katolabmain/shortcut_keyboard/PCB(kicad)/RP2040_key_board.step

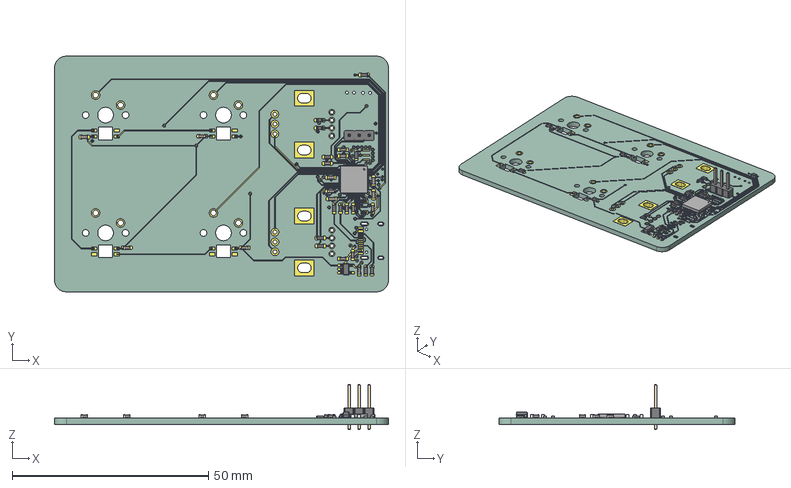
[picture p1: CAD file, 2026-10-30]
PCB(kicad)/RP2040_key_board.step
85.0 x 60.0 x 11.5 mm
R_0603_1608Metric x 11
C_0603_1608Metric x 18
QFN_56_1EP_7x7mm_P04mm_EP32x32mm
PinHeader_1x03_P254mm_Vertical
SOT_23_5
RP2040_key_board_track_1
RP2040_key_board_track_2
RP2040_key_board_track_3
RP2040_key_board_track_4
RP2040_key_board_track_5
RP2040_key_board_track_6
RP2040_key_board_track_7
RP2040_key_board_track_8
RP2040_key_board_track_9
RP2040_key_board_track_10
RP2040_key_board_track_11
RP2040_key_board_track_12
RP2040_key_board_track_13
RP2040_key_board_track_14
RP2040_key_board_track_15
RP2040_key_board_track_16
RP2040_key_board_track_17
RP2040_key_board_track_18
RP2040_key_board_track_19
RP2040_key_board_track_20
RP2040_key_board_track_21
RP2040_key_board_track_22
RP2040_key_board_track_23
RP2040_key_board_track_24
RP2040_key_board_track_25
RP2040_key_board_track_26
RP2040_key_board_track_27
RP2040_key_board_track_28
RP2040_key_board_track_29
RP2040_key_board_track_30
RP2040_key_board_track_31
RP2040_key_board_track_32
RP2040_key_board_track_33
RP2040_key_board_track_34
RP2040_key_board_track_35
RP2040_key_board_track_36
RP2040_key_board_track_37
RP2040_key_board_track_38
RP2040_key_board_track_39
RP2040_key_board_track_40
RP2040_key_board_track_41
RP2040_key_board_track_42
RP2040_key_board_track_43
RP2040_key_board_track_44
RP2040_key_board_track_45
RP2040_key_board_track_46
RP2040_key_board_track_47
RP2040_key_board_track_48
RP2040_key_board_track_49
RP2040_key_board_track_50
RP2040_key_board_track_51
RP2040_key_board_track_52
RP2040_key_board_track_53
RP2040_key_board_track_54
RP2040_key_board_track_55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
