katolabmain/shortcut_keyboard/PCB(kicad)/RP2040_key_board.kicad_pcb

## KiCad design PCB(kicad)/RP2040_key_board.kicad_pcb (2026-10-30)

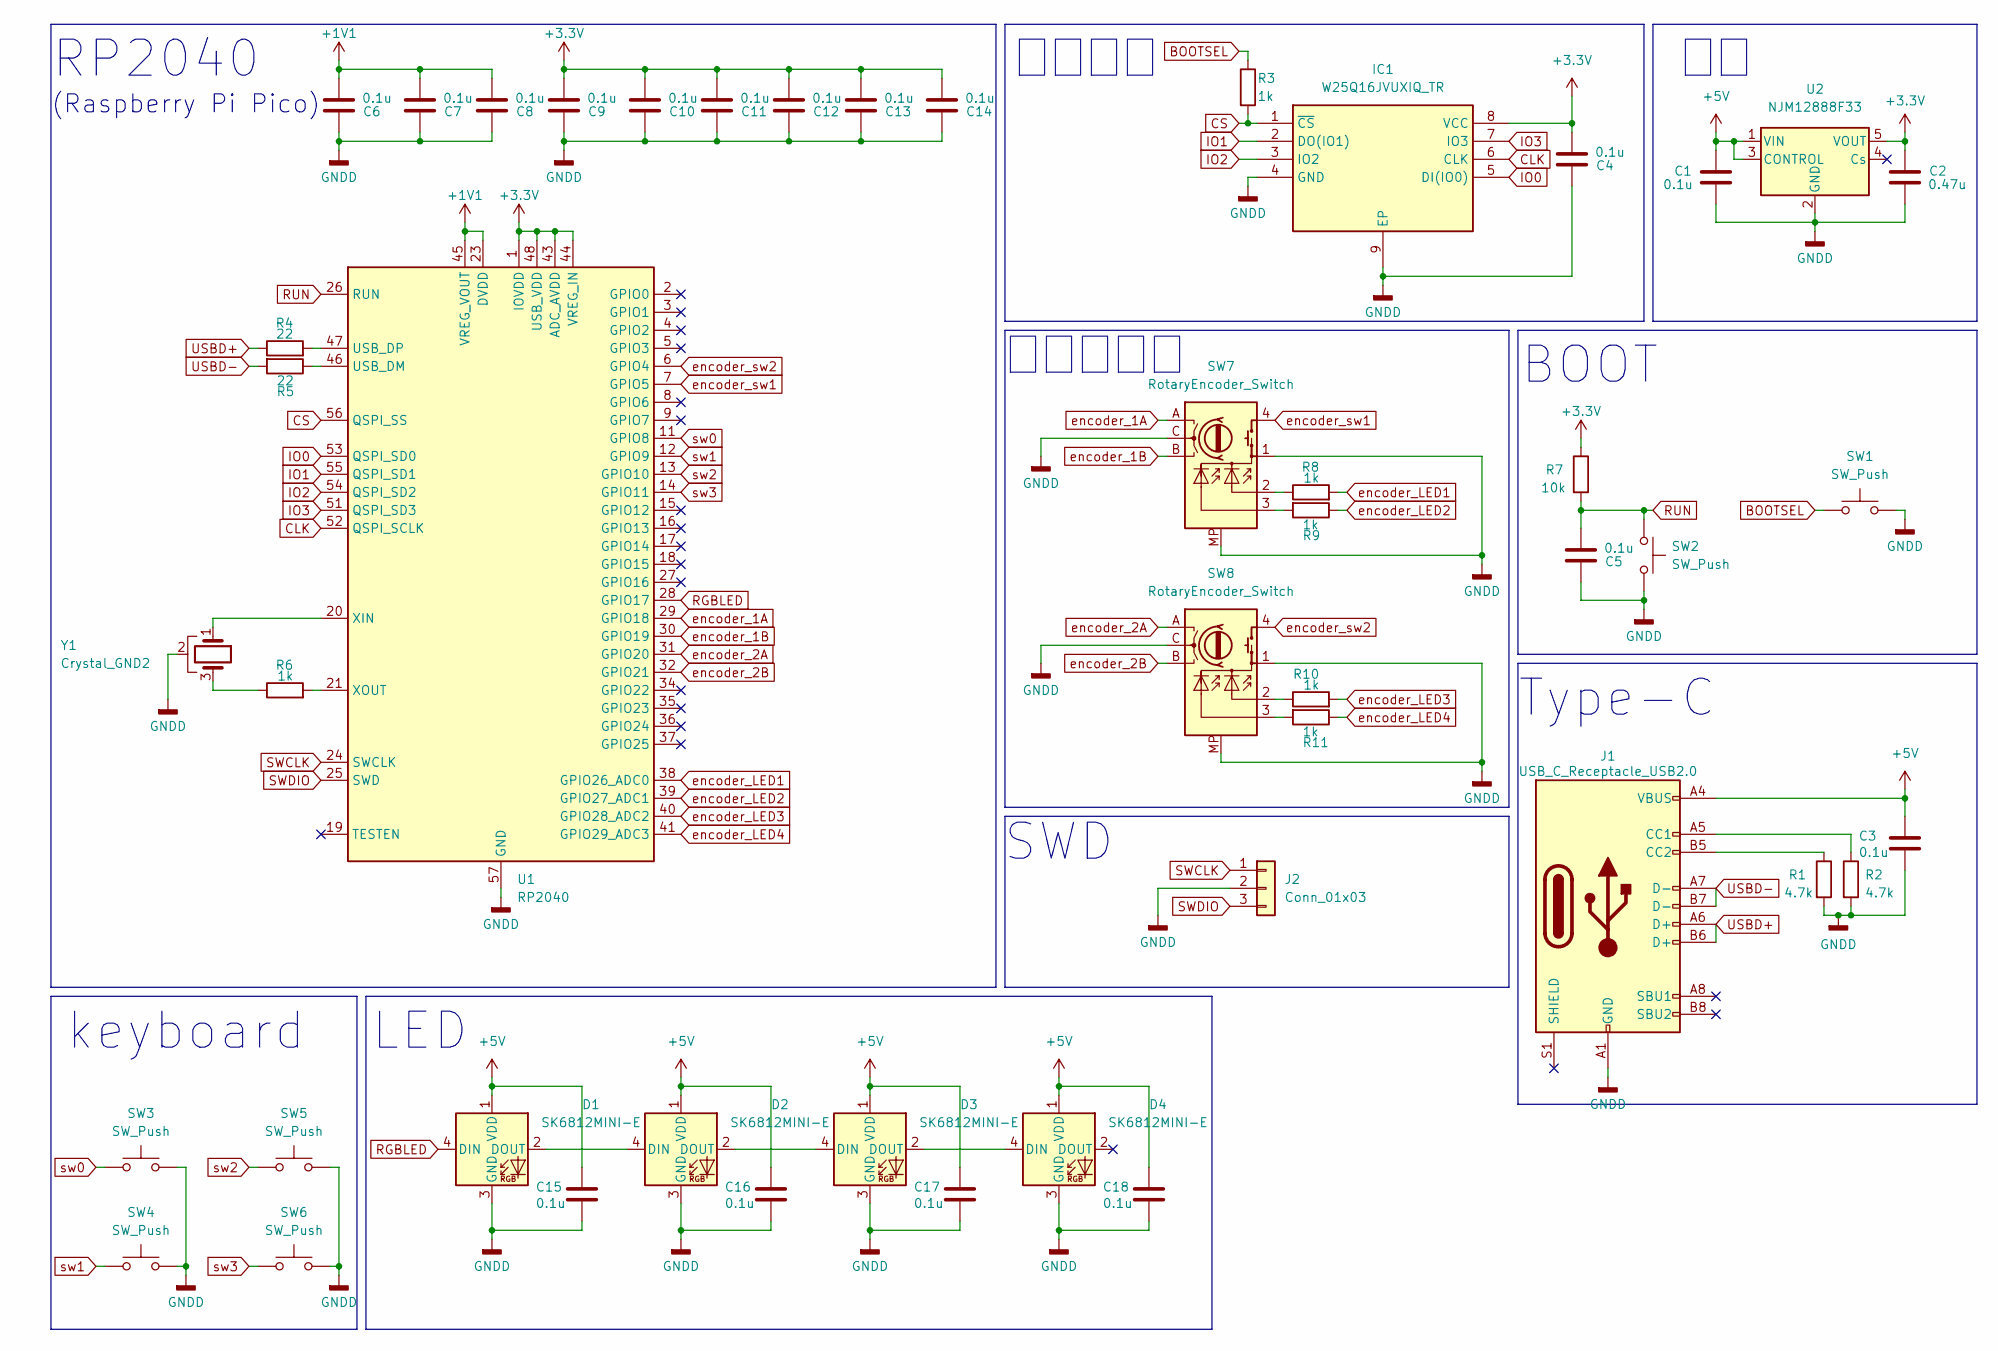
[picture p3: schematic RP2040_key_board.kicad_sch]

Parts:
C1, C3, C4, C5, C6, C7, C8, C9, C10, C11, C12, C13, C14, C15, C16, C17, C18: 0.1u; C_0603_1608Metric_Pad1.08x0.95mm_HandSolder
C2: 0.47u; C_0603_1608Metric_Pad1.08x0.95mm_HandSolder
D1, D2, D3, D4: SK6812MINI-E
IC1: W25Q16JVUXIQ_TR; SON50P300X200X60-9N; Mouser Part Number 454-W25Q16JVUXIQTR
J1: USB_C_Receptacle_USB2.0; USB_C_Receptacle_HRO_TYPE-C-31-M-12
J2: Conn_01x03; PinHeader_1x03_P2.54mm_Vertical
R1, R2: 4.7k; R_0603_1608Metric_Pad0.98x0.95mm_HandSolder
R3, R6, R8, R9, R10, R11: 1k; R_0603_1608Metric_Pad0.98x0.95mm_HandSolder
R4, R5: 22; R_0603_1608Metric_Pad0.98x0.95mm_HandSolder
R7: 10k; R_0603_1608Metric_Pad0.98x0.95mm_HandSolder
SW1, SW2: SW_Push; switch_TVAF06-A020B-R
SW3, SW4, SW5, SW6: SW_Push; SW_Cherry_MX_1.00u_PCB
SW7, SW8: RotaryEncoder_Switch; EC12PLGRSDVF-D-25K-24-24C-310
U1: RP2040; QFN-56-1EP_7x7mm_P0.4mm_EP3.2x3.2mm
U2: NJM12888F33; SOT-23-5_HandSoldering
Y1: Crystal_GND2; CSTNE16M0V530000R0

Connections:
+1V1: C6.2, C7.2, C8.2, U1.23 (DVDD), U1.45 (VREG_VOUT), U1.50 (DVDD)
+3.3V: C2.1, C4.2, C9.2, C10.2, C11.2, C12.2, C13.2, C14.2, IC1.8 (VCC), R7.1, U1.1 (IOVDD), U1.10 (IOVDD), U1.22 (IOVDD), U1.33 (IOVDD), U1.42 (IOVDD), U1.43 (ADC_AVDD), U1.44 (VREG_IN), U1.48 (USB_VDD), U1.49 (IOVDD), U2.5 (VOUT)
+5V: C1.1, C3.1, C15.1, C16.1, C17.1, C18.1, D1.1 (VDD), D2.1 (VDD), D3.1 (VDD), D4.1 (VDD), J1.A4 (VBUS), J1.A9 (VBUS), J1.B4 (VBUS), J1.B9 (VBUS), U2.1 (VIN), U2.3 (CONTROL)
BOOTSEL: R3.1, SW1.1
CLK: IC1.6 (CLK), U1.52 (QSPI_SCLK)
CS: IC1.1 (~CS), R3.2, U1.56 (QSPI_SS)
GNDD: C1.2, C2.2, C3.2, C4.1, C5.1, C6.1, C7.1, C8.1, C9.1, C10.1, C11.1, C12.1, C13.1, C14.1, C15.2, C16.2, C17.2, C18.2, D1.3 (GND), D2.3 (GND), D3.3 (GND), D4.3 (GND), IC1.4 (GND), IC1.9 (EP), J1.A1 (GND), J1.A12 (GND), J1.B1 (GND), J1.B12 (GND), J2.2, R1.2, R2.2, SW1.2, SW2.2, SW3.2, SW4.2, SW5.2, SW6.2, SW7.1, SW7.C, SW7.MP, SW8.1, SW8.C, SW8.MP, U1.57 (GND), U2.2 (GND), Y1.2
IO0: IC1.5 (DI(IO0)), U1.53 (QSPI_SD0)
IO1: IC1.2 (DO(IO1)), U1.55 (QSPI_SD1)
IO2: IC1.3 (IO2), U1.54 (QSPI_SD2)
IO3: IC1.7 (IO3), U1.51 (QSPI_SD3)
unnamed: D1.2 (DOUT), D2.4 (DIN)
unnamed: D2.2 (DOUT), D3.4 (DIN)
unnamed: D3.2 (DOUT), D4.4 (DIN)
unnamed: J1.A5 (CC1), R2.1
unnamed: J1.B5 (CC2), R1.1
unnamed: R6.1, Y1.3
unnamed: R8.1, SW7.2
unnamed: R9.2, SW7.3
unnamed: R10.1, SW8.2
unnamed: R11.2, SW8.3
unnamed: R5.1, U1.46 (USB_DM)
unnamed: R4.2, U1.47 (USB_DP)
unnamed: U1.20 (XIN), Y1.1
unnamed: R6.2, U1.21 (XOUT)
RGBLED: D1.4 (DIN), U1.28 (GPIO17)
RUN: C5.2, R7.2, SW2.1, U1.26 (RUN)
SWCLK: J2.1, U1.24 (SWCLK)
SWDIO: J2.3, U1.25 (SWD)
USBD+: J1.A6 (D+), J1.B6 (D+), R4.1
USBD-: J1.A7 (D-), J1.B7 (D-), R5.2
encoder_1A: SW7.A, U1.29 (GPIO18)
encoder_1B: SW7.B, U1.30 (GPIO19)
encoder_2A: SW8.A, U1.31 (GPIO20)
encoder_2B: SW8.B, U1.32 (GPIO21)
encoder_LED1: R8.2, U1.38 (GPIO26_ADC0)
encoder_LED2: R9.1, U1.39 (GPIO27_ADC1)
encoder_LED3: R10.2, U1.40 (GPIO28_ADC2)
encoder_LED4: R11.1, U1.41 (GPIO29_ADC3)
encoder_sw1: SW7.4, U1.7 (GPIO5)
encoder_sw2: SW8.4, U1.6 (GPIO4)
sw0: SW3.1, U1.11 (GPIO8)
sw1: SW4.1, U1.12 (GPIO9)
sw2: SW5.1, U1.13 (GPIO10)
sw3: SW6.1, U1.14 (GPIO11)

Notes on the sheet:
LED
BOOT
Type-C
RP2040
エンコーダ
keyboard
メモリー
SWD
(Raspberry Pi Pico)

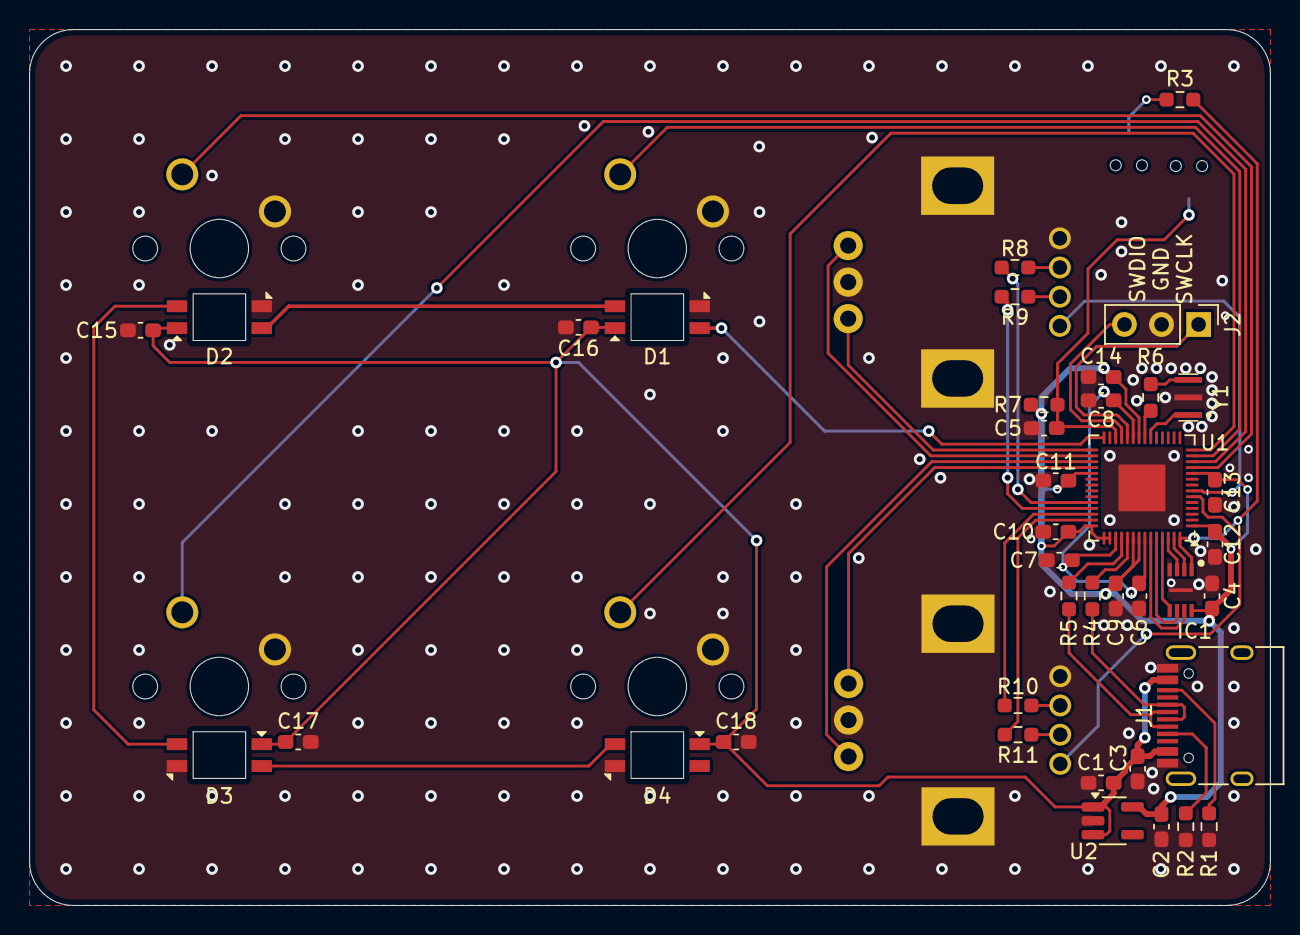
[picture p4: board RP2040_key_board.kicad_pcb from above]

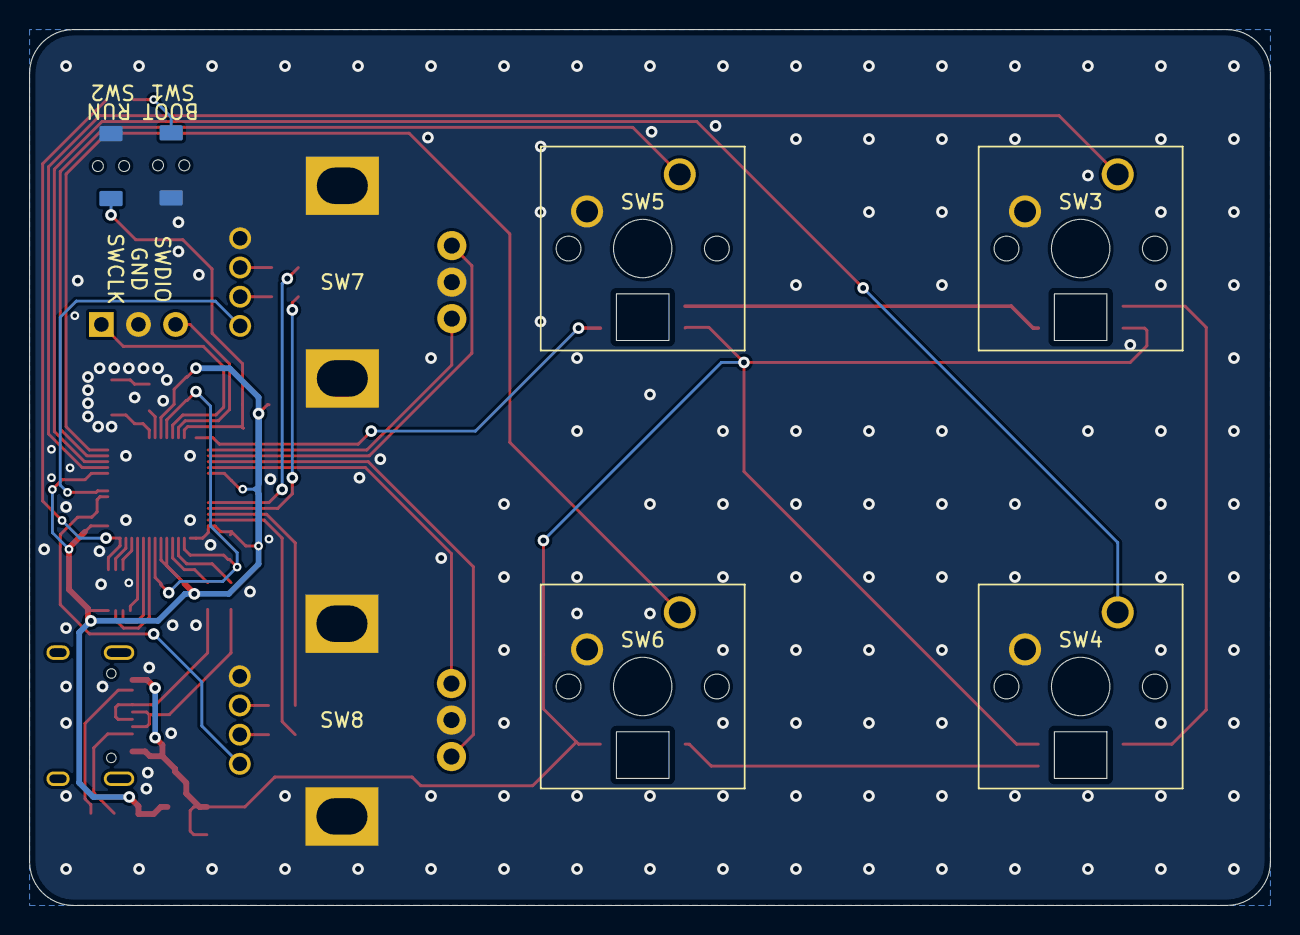
[picture p5: board RP2040_key_board.kicad_pcb from below]

Board: 2 copper layers, 85.0 x 60.0 mm, 47 parts (8 on the bottom side), 45 nets.
