katolabmain/shortcut_keyboard/Firmware/include/pin.h

#pragma once

// 基板のGPIO割り当て
namespace PIN {
static const int RGBLED_PIN = 17;
static const int NUM_LEDS = 4;

static const int ENC1_PIN_A = 18;
static const int ENC1_PIN_B = 19;
static const int ENC2_PIN_A = 20;
static const int ENC2_PIN_B = 21;

static const int ENC2_SW_PIN = 4;
static const int ENC1_SW_PIN = 5;

static const int ENC1_LED1 = 26;
static const int ENC1_LED2 = 27;
static const int ENC2_LED1 = 28;
static const int ENC2_LED2 = 29;

static const int sw1 = 8;
static const int sw2 = 9;
static const int sw3 = 10;
static const int sw4 = 11;
}
