katolabmain/shortcut_keyboard/(commit log)

2026-10-20 index.htmlの追加
2026-10-20 githubのリンクを変更
2026-10-30 仕様書、ファームウェア、PCBデータの追加
    [RP2040_key_board.kicad_pcb, RP2040_key_board.kicad_sch, RP2040_key_board.step]
